ENTC-Lab-Group-21/Voice_Recorder-Arduino/(list of files, drawings)

Other design files:
audio_input.pdsprj
Keypad.pdsprj
Limalka/LCD/lcd.pdsprj
Limalka/voice_recorder.pdsprj
Maleesha/test_mic.pdsprj
Maleesha/voice_rec2.pdsprj
Rukmal/collaborate/using Mega.pdsprj
Rukmal/external_DAC.pdsprj
Rukmal/PWM_timers.pdsprj
SD simulation/Voice_Rec_SD.pdsprj
