ENTC-Lab-Group-21/Voice_Recorder-Arduino/Rukmal/collaborate/file_handle.ino

void openfile(String filename){
  data_file = SD.open(filename,FILE_READ);
  data_file.seek(50);
  Serial.println("open the file & go to 44th byte");
}

void closefile(String filename){
  data_file.close();
  Serial.println("file closed");
}
