ENTC-Lab-Group-21/Voice_Recorder-Arduino/(commit log)

2021-04-01 sample sound
2021-04-04 Add files via upload
    Proteus file for keypad and LCD
    [Keypad.pdsprj]
2021-04-08 filter adjusted
2021-04-08 Add SD simulation files
    SD simulation for voice recorder with Uno board
2021-05-07 play wav in PWM using 2 timers
2021-05-07 proteus cct for PWM timer code
    [PWM_timers.pdsprj]
2021-05-07 proteus cct for external DAC
    [external_DAC.pdsprj]
2021-05-11 LCD module
    [lcd.pdsprj]
2021-05-18 with rukshanth
    [using Mega.pdsprj]
